mizutanilab/BluetoothDials/pics/RS232Cmodels.png

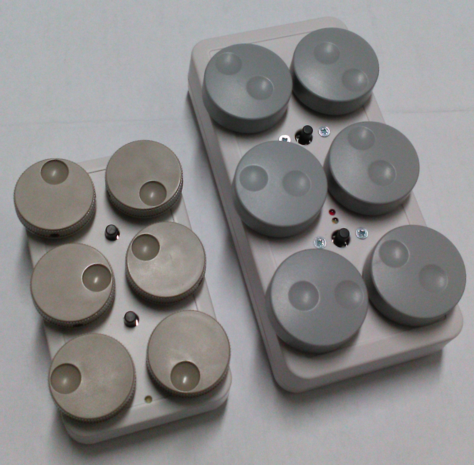
pics/RS232Cmodels.png
