mizutanilab/BluetoothDials/(list of files, drawings)

Other design files:
gerber/boardR7_200430.pcb
